moolenaar/zonwering/enclosure/button.FCStd

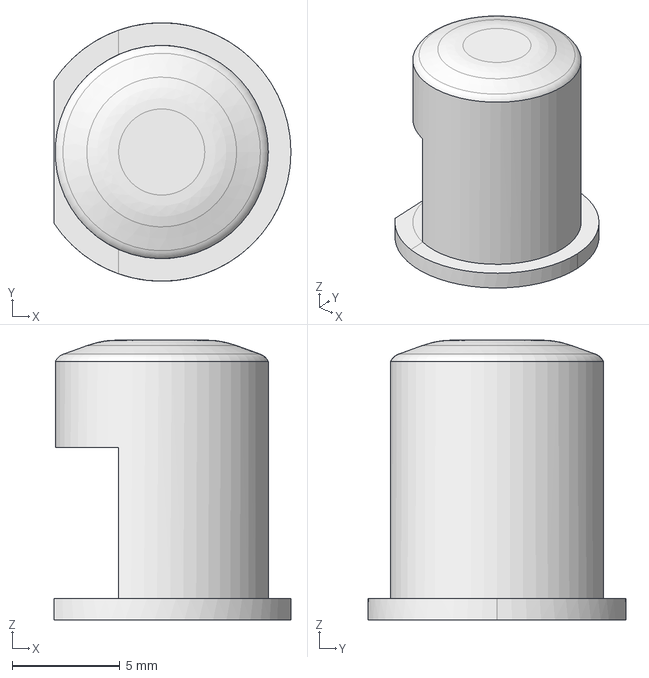
[picture p1: CAD file, 2020-05-24]
enclosure/button.FCStd
11.0 x 12.0 x 13.0 mm
