moolenaar/zonwering/enclosure/front.FCStd

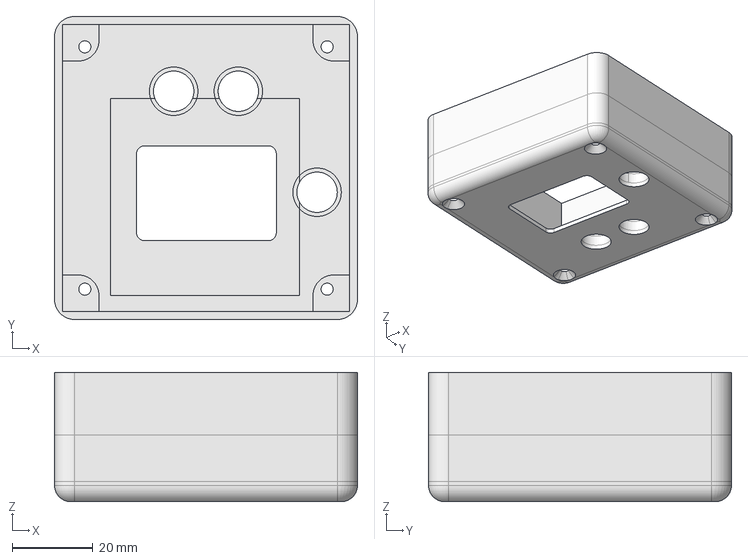
[picture p2: CAD file, 2020-02-02]
enclosure/front.FCStd
75.0 x 75.0 x 32.0 mm
