moolenaar/zonwering/enclosure/bottom.FCStd

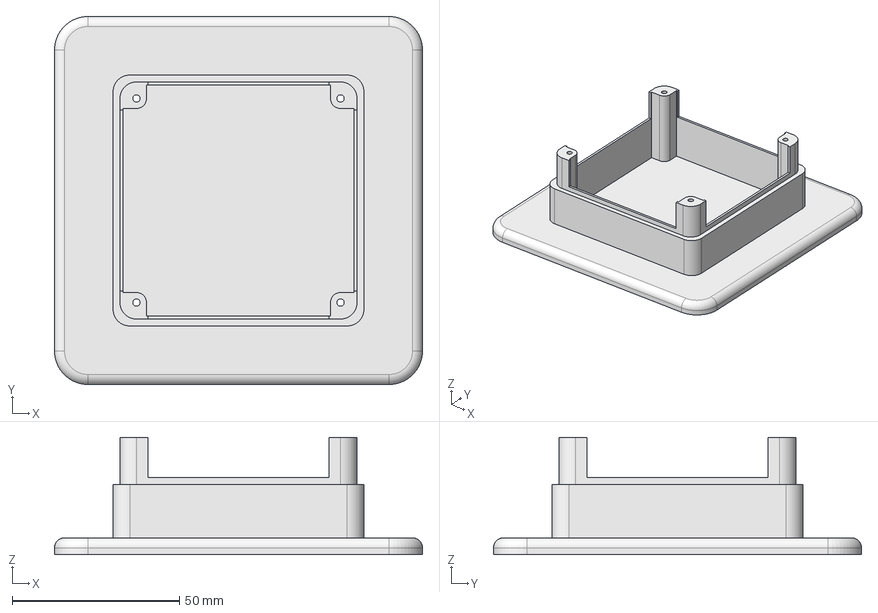
[picture p3: CAD file, 2020-02-02]
enclosure/bottom.FCStd
110.0 x 110.0 x 35.0 mm
