moolenaar/zonwering/(list of files, drawings)

Other design files:
electronics/zonwering.dsn
