moolenaar/zonwering/electronics/zonwering.kicad_pcb

## KiCad design electronics/zonwering.kicad_pcb (2020-01-05)

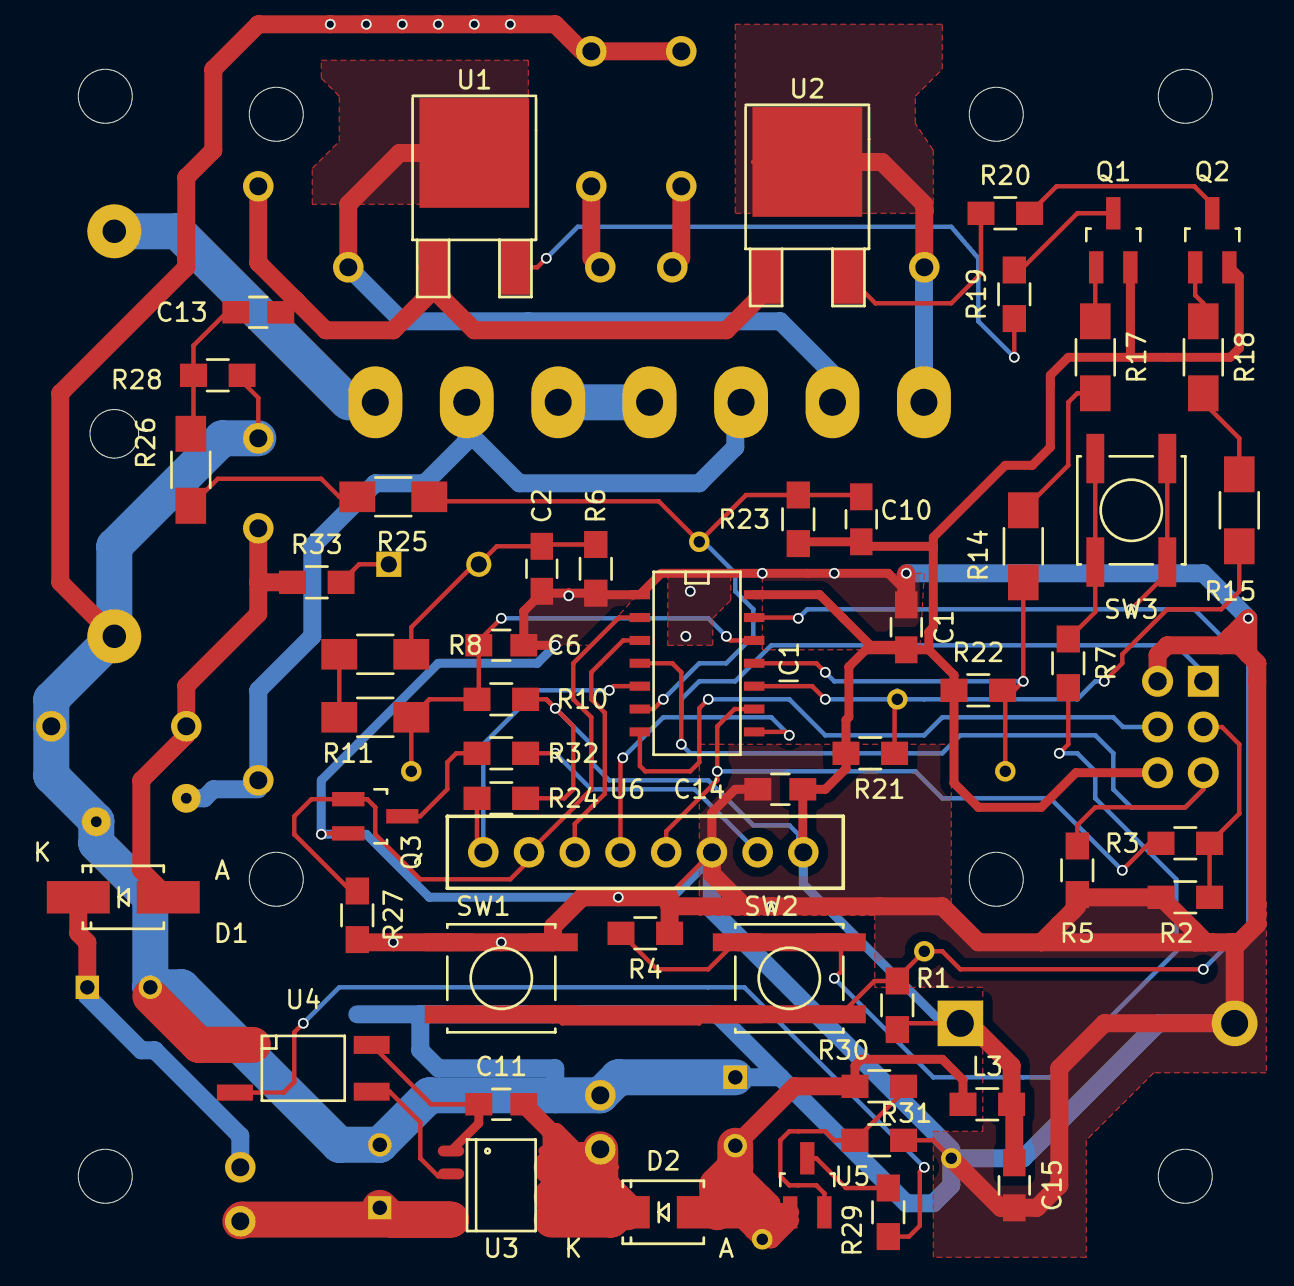
[picture p4: board zonwering.kicad_pcb from above]

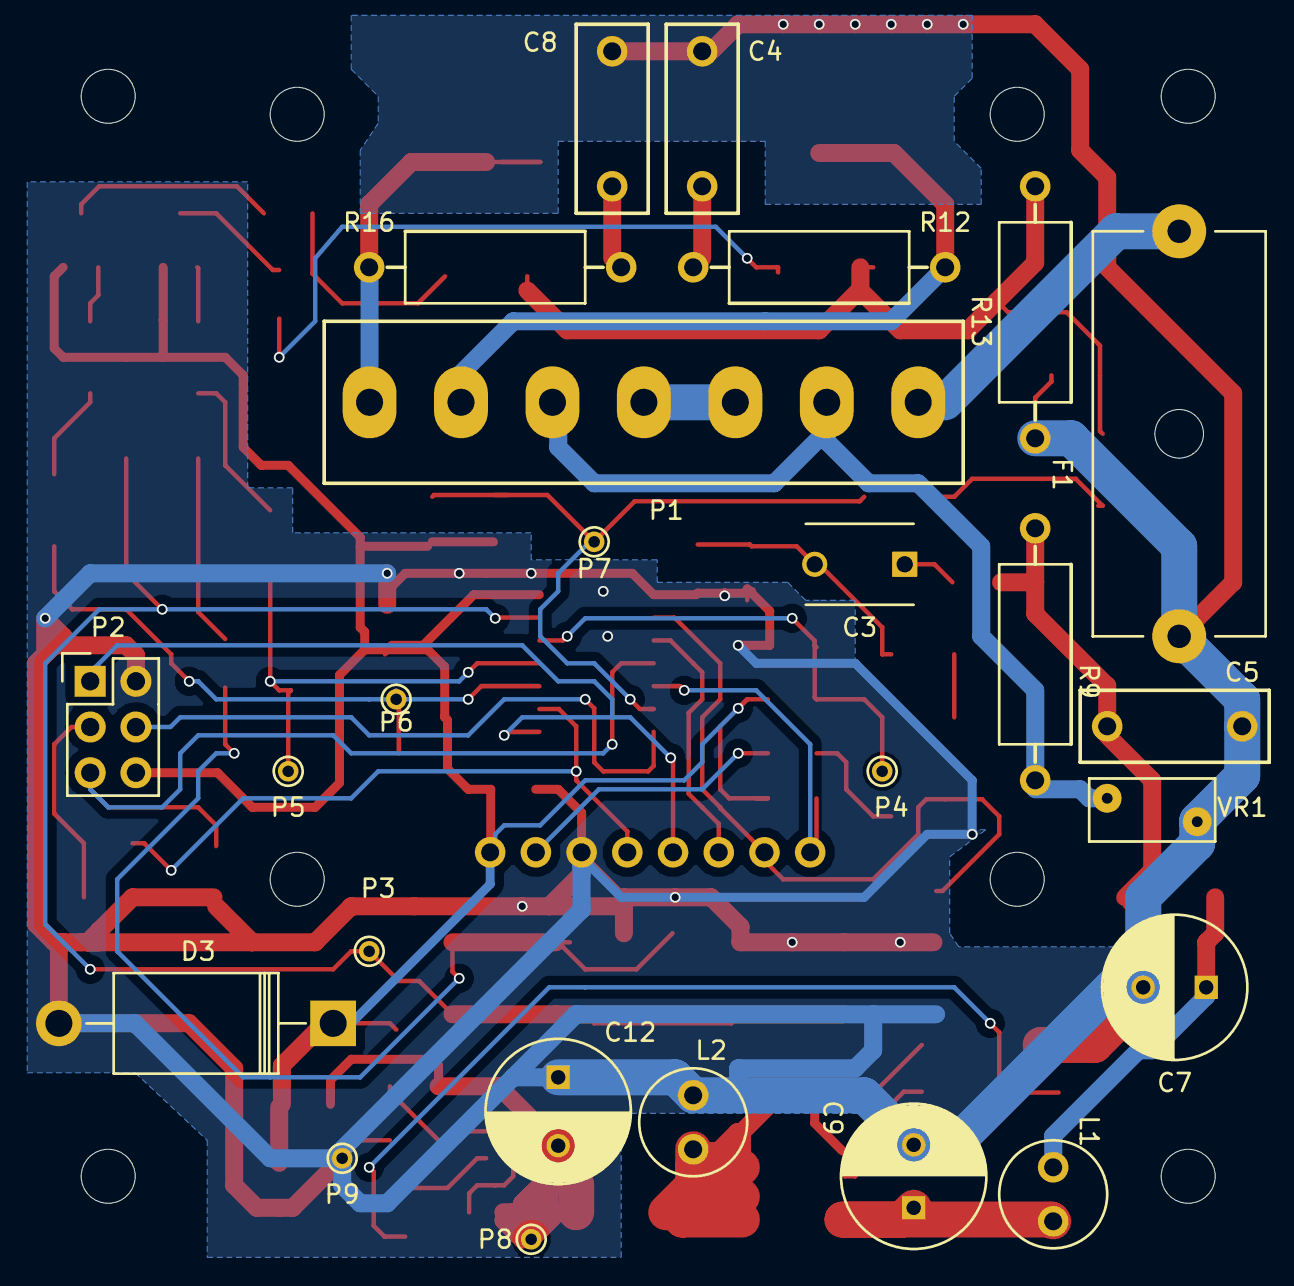
[picture p5: board zonwering.kicad_pcb from below]

Board: 2 copper layers, 82 parts (25 on the bottom side), 50 nets.

Parts:
C1, C11, C13, C14: 100nF; C_0805_HandSoldering
C2: 150nF; C_0805_HandSoldering
C3: 470pF; C_Disc_D6_P5
C4, C5, C8: 10nF; capacitor_RM7.5
C6, C10: 100pF; C_0805_HandSoldering
C7, C9: 2.2uF; C_Radial_D8_L11.5_P3.5
C12: 100uF; C_Radial_D8_L13_P3.8
C15: 1uF; C_0805_HandSoldering
D1, D2: US1M; SMA_Handsoldering
D3: ZD 5W 4,7V; Diode_DO-201AD_Horizontal_RM15
F1: 1A slow; Fuseholder5x20_horiz_open_Schurter_0031_8201
IC1: ATTINY84S; SOIC-14_N
L1: 100uH; Choke_6mm
L2: 1mH; Choke_6mm
L3: 10uH; R_0805_HandSoldering
P1: CONN_01X07; Power_connector_Straight_508_7pin
P2: CONN_02X03; Pin_Header_Straight_2x03
P3: key; PINTST
P4: mains; PINTST
P5: down; PINTST
P6: up; PINTST
P7: sense; PINTST
P8: -3.3V; PINTST
P9: 0V; PINTST
Q1, Q2: BSS138; SOT-23_Handsoldering
Q3: OA3401A; SOT-23_Handsoldering
R1, R2, R21, R22, R24, R27: 100k; R_0805_HandSoldering
R3, R5: 4.7k; R_0805_HandSoldering
R4, R7, R30: 47k; R_0805_HandSoldering
R6, R10, R23, R28: 1M; R_0805_HandSoldering
R8, R11, R14, R15, R17, R18, R25, R26: 100k; R_1206_HandSoldering
R9: 47; Resistor_14mm
R12, R16: 2.2k; Resistor_14mm
R13: 1; Resistor_14mm
R19, R20, R33: 100; R_0805_HandSoldering
R29: 10; R_0805_HandSoldering
R31: 12k; R_0805_HandSoldering
R32: 22; R_0805_HandSoldering
REF1, REF2, REF3, REF4: MountingHole_3mm
SW1, SW2, SW3: tactile switch; SW_SPST_EVPBF
U1, U2: BT137S-600E; TO-252-2Lead
U3: LNK302D; SO-8C
U4: PC817; Optocoupler_SMD_HandSoldering_KPC357_LTV35x_PC357_SingleCha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
U5: TL431; SOT-23_Handsoldering
U6: LCD5110; Nokia_lcd5110
VR1: JVR7N391K; RV_Disc_D7_W3.5_P5

Connections:
-3V3: C1.2, C10.2, C14.2, C15.1, D3.1, IC1.14, L3.2, P2.6, Q1.2, Q2.2, R1.2, R10.2, R21.1, R22.1, R23.2, R24.2, U6.8
/CLK: P2.3, R2.2, R3.2
/MOSI: IC1.7, P2.4
/RST: IC1.4, P2.5, R5.2
D/nC: IC1.3, U6.3
DOWN: R19.1, U1.3
GND: C1.1, C2.1, C4.2, C5.2, C6.1, C7.2, C8.2, C9.2, C12.1, C14.1, C15.2, D3.2, F1.1, IC1.1, L2.1, P2.2, P9.1, Q3.2, R2.1, R4.2, R5.1, R6.1, R13.2, R27.1, R28.2, R31.2, SW1.1, U4.1, U6.6, VR1.2
LCDCLK: IC1.9, R3.1, U6.5
LCDDin: IC1.8, P2.1, U6.4
unnamed: C2.2, C3.2, R6.2, R8.2
unnamed: C3.1, R33.2
unnamed: C4.1, R12.2
unnamed: C5.1, D1.2, R9.1, R33.1
unnamed: C6.2, IC1.12, P4.1, R10.1, R11.1
unnamed: C7.1, D1.1, L1.1
unnamed: C8.1, R16.2
unnamed: C9.1, L1.2, U3.4
unnamed: C10.1, IC1.6, P7.1, R23.1, R25.2
unnamed: C11.1, U3.1, U4.4
unnamed: C11.2, D2.1, L2.2, U3.5, U3.6, U3.7, U3.8
unnamed: C12.2, D2.2, L3.1, P8.1, R30.1, U5.1
unnamed: C13.2, R26.1, R28.1
unnamed: F1.2, P1.1
unnamed: IC1.10, P6.1, R15.2, R21.2
unnamed: IC1.11, P5.1, R14.2, R22.2
unnamed: IC1.13, P3.1, R1.1, SW1.2, SW2.2, SW3.2
unnamed: P1.2, P1.5, R9.2, VR1.1
unnamed: P1.3, P1.4
unnamed: P1.6, R12.1, U1.2
unnamed: P1.7, R16.1, U2.2
unnamed: Q1.1, R17.1
unnamed: Q1.3, R19.2
unnamed: Q2.1, R18.1
unnamed: Q2.3, R20.2
unnamed: Q3.3, R32.1
unnamed: R4.1, R7.2, SW2.1
unnamed: R7.1, SW3.1
unnamed: R8.1, R11.2
unnamed: R14.1, R17.2
unnamed: R15.1, R18.2
unnamed: R25.1, R26.2
unnamed: R29.1, U4.2
unnamed: R29.2, U5.3
unnamed: R30.2, R31.1, U5.2
unnamed: R32.2, U6.7
unnamed: U3.2, U4.3
SENSE: C13.1, R13.1, U1.1, U2.1
UP: R20.1, U2.3
nCE: IC1.2, Q3.1, R27.2, U6.2
nRESET: IC1.5, R24.1, U6.1
