moolenaar/zonwering/software/src/kernel.c

/* kernel.c
 * Copyright 2015 - 2019 Herman Moolenaar
 * This file is part of zonwering.
 *
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
 * You should have received a copy of the GNU General Public License
 * along with zonwering. If not, see <http://www.gnu.org/licenses/>.
 */

#include "kernel.h"
#include <stddef.h>
#include <avr/interrupt.h>
#include <util/atomic.h>
#include <avr/sleep.h>
#include <stdbool.h>

// task stack structure:
// stack start address 0  return address low  (buffer address + buffer size - 1) 
//                     1  return address high
//                     2  R0
//                     3  SREG
//                     4  R31 - R1
//                    35  SPL
//                    36  SPH
//                    37  stack pointer value (is not used here so can be used elseware)

typedef struct 
{
   uint8_t* stackbuffer;
   volatile uint16_t StackPointer;
   uint16_t StackSize;
   uint8_t Handle;
   volatile enum TaskState_t TaskState;
   volatile uint16_t NextRunTime;
} TaskStruct_t;

volatile TaskStruct_t tasks[NRTASKS];

volatile uint8_t TaskIndex;
volatile uint8_t TaskIterator;
volatile uint16_t KernelTimerCounter;
volatile uint8_t nrTasks;

uint8_t IdleTaskStack[MINIMUMSTACKSIZE];

TaskFunction initFunction;

void IdleTask(void);

void IdleTask(void)
{
   if (initFunction != NULL)
   {
      initFunction();
   }

   while(true)
   {
      TaskSleep(0);
   }
}

void KernelSetup()
{
   // timer / counter 0 is used to generate the 1 ms timing
   KernelTimerCounter = 0;
   TCCR0A = (1<<WGM01);            // CTC mode
   TCCR0B = (1<<CS01);             // 8 MHz divide by 64 prescaler produces 125 KHz clock source
   OCR0A = 124;                    // 125 - 1 gives 1 ms compare match interrupts used for task switching

   nrTasks = 0;
   InitTask(sizeof(IdleTaskStack), IdleTaskStack, IdleTask);
}

uint8_t InitTask(uint16_t stackSize, uint8_t* stackBuffer, TaskFunction function)
{
   uint8_t* stackptr = stackBuffer + stackSize - 1;
   
   *stackptr-- = (uint16_t)function & 0x00ff;
   *stackptr-- = (uint16_t)function >> 8;
   *stackptr-- = 0x00;                                         // register R0
   *stackptr-- = 0x00; nrTasks == 0 ? 0x00 : 0x80;             // status register; interrupt will be enabled later

   tasks[nrTasks].stackbuffer = stackBuffer;
   tasks[nrTasks].StackPointer = (uint16_t)stackptr - 31;      // store stack pointer
   tasks[nrTasks].StackSize = stackSize;
   tasks[nrTasks].Handle = nrTasks;
   tasks[nrTasks].TaskState = StateRunable;
   tasks[nrTasks].NextRunTime = 0;

   return nrTasks++;
}

__attribute__((optimize("O"))) void StartKernel(TaskFunction function)
{
   TaskIndex = 0;
   initFunction = function;
   
   EnableTaskSwitching();
   SP = tasks[TaskIndex].StackPointer;

   __asm volatile(
      "rjmp start \n\t"
   ::);
   // this function starts / returns the first task in the list
}

__attribute__((optimize("O"))) void TaskSleep(uint16_t time)
{
   // store context of current task
   __asm volatile(
      "              cli               \n\t"
      "              push r0           \n\t" // r0
      "              in r0, 0x3f       \n\t" // SREG
      "              push r0           \n\t"
      "              push r1           \n\t"
      "              push r2           \n\t"
      "              push r3           \n\t"
      "              push r4           \n\t"
      "              push r5           \n\t"
      "              push r6           \n\t"
      "              push r7           \n\t"
      "              push r8           \n\t"
      "              push r9           \n\t"
      "              push r10          \n\t"
      "              push r11          \n\t"
      "              push r12          \n\t"
      "              push r13          \n\t"
      "              push r14          \n\t"
      "              push r15          \n\t"
      "              push r16          \n\t"
      "              push r17          \n\t"
      "              push r18          \n\t"
      "              push r19          \n\t"
      "              push r20          \n\t"
      "              push r21          \n\t"
      "              push r22          \n\t"
      "              push r23          \n\t"
      "              push r24          \n\t"
      "              push r25          \n\t"
      "              push r26          \n\t"
      "              push r27          \n\t"
      "              push r28          \n\t"
      "              push r29          \n\t"
      "              push r30          \n\t"
      "              push r31          \n\t"
      "              clr r1            \n\t" // reset the "zero" register
   ::);
   
   tasks[TaskIndex].StackPointer = SP;

   if (time > 0)
   {
      tasks[TaskIndex].TaskState = StateWaiting;
      tasks[TaskIndex].NextRunTime = KernelTimerCounter + time;
   }

   // find new task to run
   if (TaskIndex == 0) TaskIndex++;
   TaskIterator = TaskIndex;
   do
   {
      TaskIterator = TaskIterator >= nrTasks - 1 ? 1 : TaskIterator + 1;
   }
   while ((TaskIterator != TaskIndex) && (tasks[TaskIterator].TaskState != StateRunable));

   TaskIndex = tasks[TaskIterator].TaskState == StateRunable ? TaskIterator : 0;

   // retrieve context of next task to run
   SP = tasks[TaskIndex].StackPointer;

   __asm volatile(
      "start:        pop r31          \n\t"
      "              pop r30          \n\t"
      "              pop r29          \n\t"
      "              pop r28          \n\t"
      "              pop r27          \n\t"
      "              pop r26          \n\t"
      "              pop r25          \n\t"
      "              pop r24          \n\t"
      "              pop r23          \n\t"
      "              pop r22          \n\t"
      "              pop r21          \n\t"
      "              pop r20          \n\t"
      "              pop r19          \n\t"
      "              pop r18          \n\t"
      "              pop r17          \n\t"
      "              pop r16          \n\t"
      "              pop r15          \n\t"
      "              pop r14          \n\t"
      "              pop r13          \n\t"
      "              pop r12          \n\t"
      "              pop r11          \n\t"
      "              pop r10          \n\t"
      "              pop r9           \n\t"
      "              pop r8           \n\t"
      "              pop r7           \n\t"
      "              pop r6           \n\t"
      "              pop r5           \n\t"
      "              pop r4           \n\t"
      "              pop r3           \n\t"
      "              pop r2           \n\t"
      "              pop r1           \n\t"
      "              pop r0           \n\t"
      "              out 0x3f, r0     \n\t" // SREG
      "              pop r0           \n\t" // r0
      "              sei              \n\t"
      "              ret              \n\t"
   ::);
}

__attribute__((optimize("O"))) void TaskStart(uint8_t index)
{
   ATOMIC_BLOCK(ATOMIC_FORCEON)
   {
      tasks[index].TaskState = StateRunable;
   }   
}

__attribute__((optimize("O"))) void TaskStop(uint8_t index)
{
   ATOMIC_BLOCK(ATOMIC_FORCEON)
   {
      tasks[index].TaskState = StateStopped;
   }
}

__attribute__((optimize("O"))) void EnableTaskSwitching(void)
{
   TIMSK0 |= (1<<OCIE0A);           // enable timer 0 compare match interrupt
}

__attribute__((optimize("O"))) ISR (TIM0_COMPA_vect)
{
   static uint8_t delay = 0;
   static uint8_t i;
   
   sei(); // allow other interrupts (ADC)
   
   delay++;
   if (delay == 10)
   {
      delay = 0;
      KernelTimerCounter++;

      // update status of each task
      for (i = 0; i < nrTasks; i++)
      {
         if ((tasks[i].NextRunTime == KernelTimerCounter) &&
            (tasks[i].TaskState != StateStopped))
         {
            tasks[i].TaskState = StateRunable;
         }
      }
   }
}
