moolenaar/zonwering/(commit log)

2020-01-05 first checkin status: changes in schematic, PCB need to be updated software changed for testing ADC
    [zonwering.csv, zonwering.dsn, zonwering.kicad_pcb, zonwering.sch]
2020-01-14 motor control works, open / close timer works, key press works todo: eeprom storage, automatic closing timer and seeting value for fully open
2020-01-16 pressing up key when moving down stops motor
2020-01-18 Added idle screen and switch off backlight when not in use
2020-01-19 removed current measurement noticed that, after programming, the checksum of the parameters is rejected
    [zonwering.sch]
2020-01-28 added front side of enclosure; not good
    [front.FCStd]
2020-02-01 corrected position of lcd window, rounded front edges, still not ok
    [front.FCStd]
2020-02-02 front and button ok, bottom plate not finished
    [bottom.FCStd, button.FCStd, front.FCStd]
2020-05-24 - 600v triac was not enough - increased additional closing time
    [button.FCStd, zonwering.sch]
